TDT4295-2019-groupA/PCB/Synthesizer.kicad_pcb

## KiCad design Synthesizer.kicad_pcb (2019-10-03)

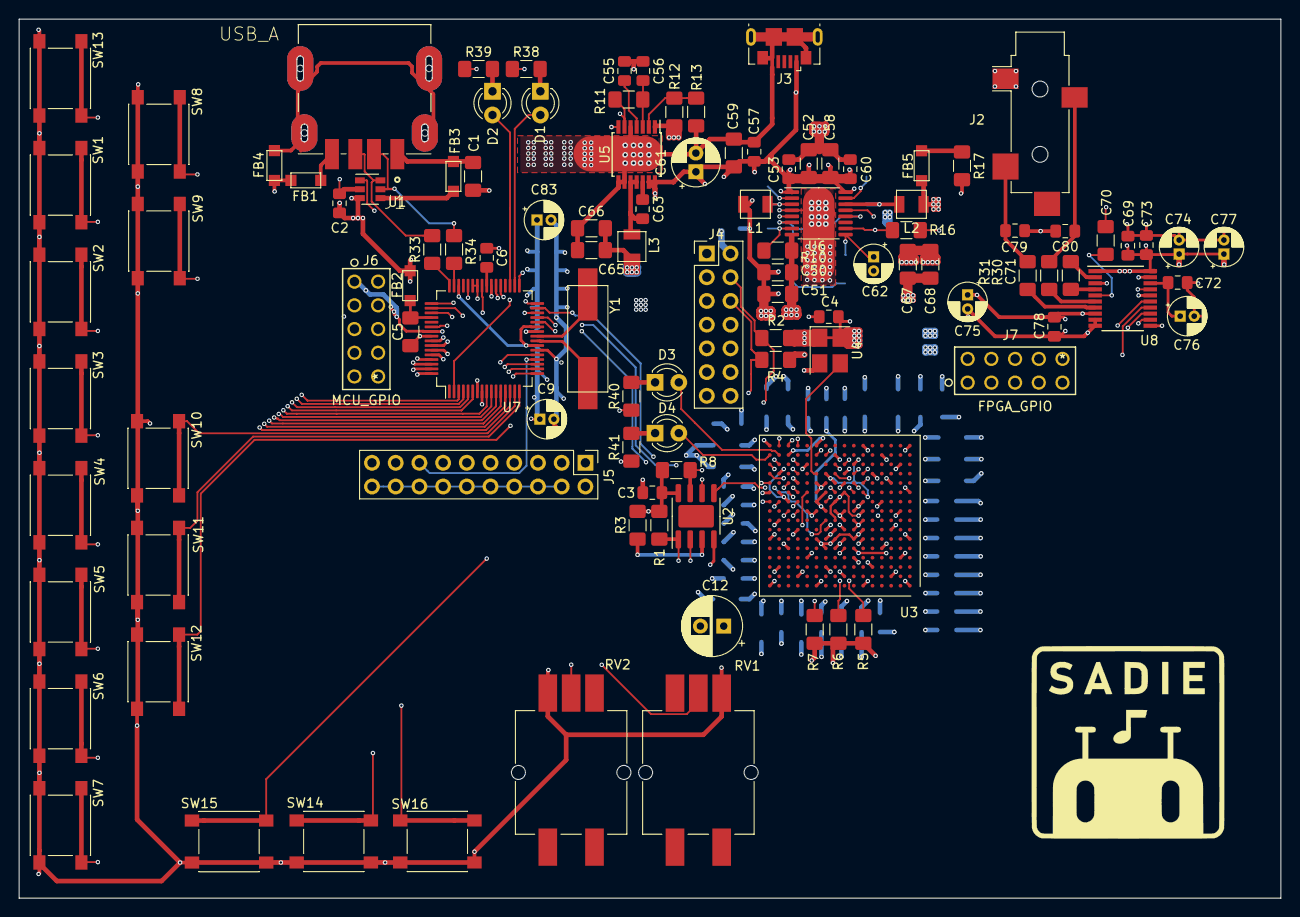
[picture p1: board Synthesizer.kicad_pcb from above]

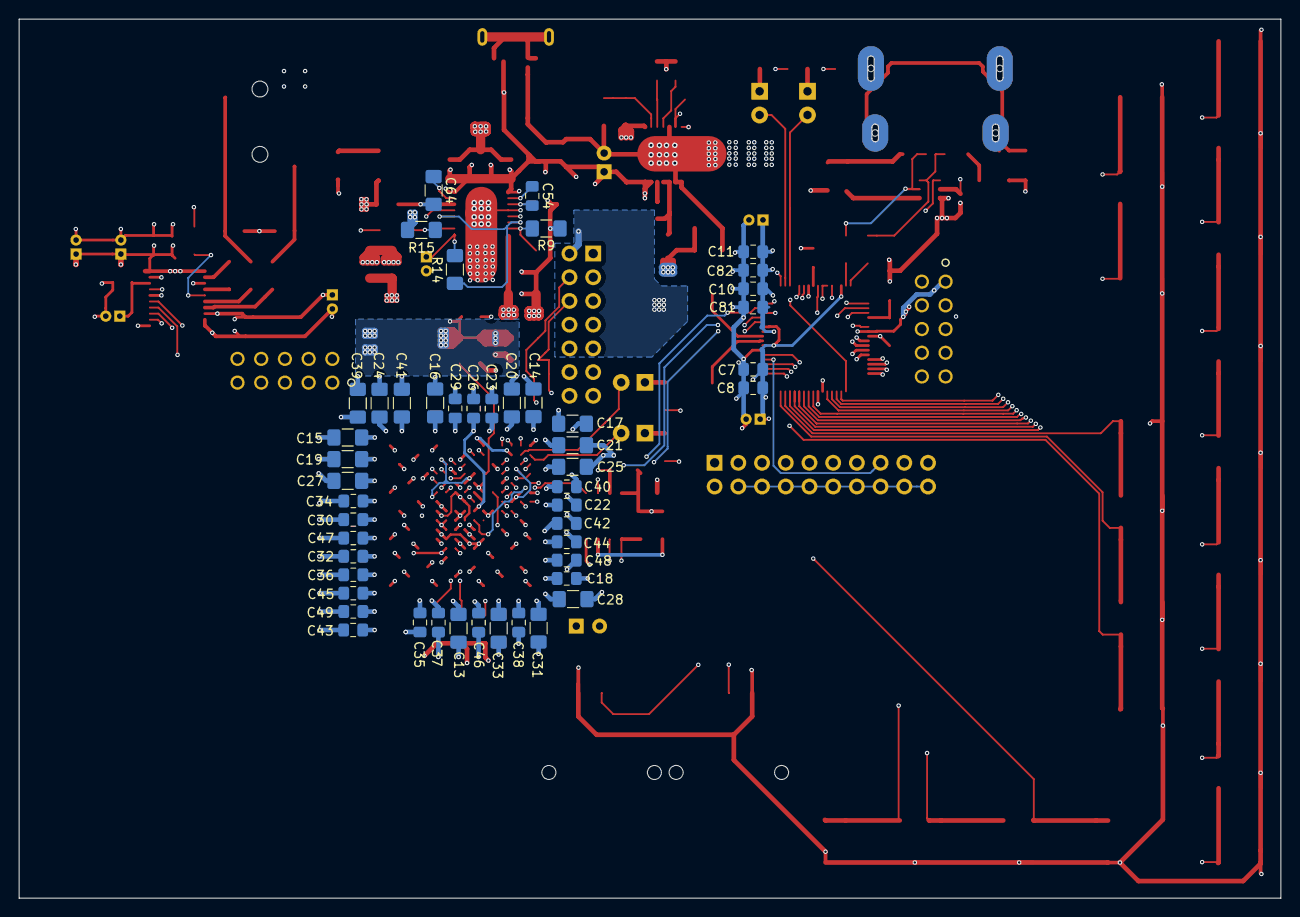
[picture p2: board Synthesizer.kicad_pcb from below]

Board: 6 copper layers, 135.2 x 94.2 mm, 154 parts (48 on the bottom side), 114 nets.

Parts:
C1: 150u; C_1206_3216Metric_Pad1.42x1.75mm_HandSolder
C2, C3, C4, C7, C8, C10, C11, C53, C54, C57, C60, C63, C69, C72, C73, C78, C81, C82: 100n; C_0805_2012Metric_Pad1.15x1.40mm_HandSolder
C5, C13, C19: 100u; C_1206_3216Metric_Pad1.42x1.75mm_HandSolder
C6, C56: 1u; C_0805_2012Metric_Pad1.15x1.40mm_HandSolder
C9, C74, C75, C76, C77, C83: 10u; CP_Radial_D4.0mm_P1.50mm
C12: 330u; CP_Radial_D6.3mm_P2.50mm
C14, C15: 47u; C_1206_3216Metric_Pad1.42x1.75mm_HandSolder
C16, C17, C20, C21, C24, C25, C27, C28, C31, C33, C39, C41: 4.7u; C_1206_3216Metric_Pad1.42x1.75mm_HandSolder
C18, C22, C23, C26, C29, C30, C32, C34, C35, C36, C37, C38, C40, C42, C43, C44, C45, C46, C47, C48, C49: 470n; C_0805_2012Metric_Pad1.15x1.40mm_HandSolder
C50, C51, C65, C66, C67, C68: 22u; C_1206_3216Metric_Pad1.42x1.75mm_HandSolder
C52, C58, C59: 10u; C_1206_3216Metric_Pad1.42x1.75mm_HandSolder
C55: 3.3n; C_0805_2012Metric_Pad1.15x1.40mm_HandSolder
C61: 100u; CP_Radial_D5.0mm_P2.00mm
C62: 1u; CP_Radial_D4.0mm_P1.50mm
C64: 100n; C_1206_3216Metric_Pad1.42x1.75mm_HandSolder
C70, C71: 2.2u; C_1206_3216Metric_Pad1.42x1.75mm_HandSolder
C79, C80: 2.2n; C_0805_2012Metric_Pad1.15x1.40mm_HandSolder
D1, D2, D3, D4: LED; LED_D3.0mm
FB1, FB2, FB3, FB4, FB5: Ferrite_Bead; FerriteBead_74279215
J1: USB_A; TE_1932638-3
J2: AudioJack3; Jack_3.5mm_CUI_SJ-3524-SMT_Horizontal
J3: USB_B_Micro; USB_Micro-B_GCT_USB3076-30-A
J4: FPGA_debug; PinHeader_2x07_P2.54mm_Vertical
J5: MCU_debug; PinHeader_2x10_P2.54mm_Vertical
J6: MCU_GPIO; 67997-410HLF
J7: FPGA_GPIO; 67997-410HLF
L1, L3: 1.5u; L_SPM3015
L2: 2.2u; L_SPM3015
R1: 2.4k; R_1206_3216Metric_Pad1.42x1.75mm_HandSolder
R2, R4: 10k; R_1206_3216Metric_Pad1.42x1.75mm_HandSolder
R3, R5, R6, R8: 4.7k; R_1206_3216Metric_Pad1.42x1.75mm_HandSolder
R7: 330; R_1206_3216Metric_Pad1.42x1.75mm_HandSolder
R9: 30.1k; R_1206_3216Metric_Pad1.42x1.75mm_HandSolder
R10, R13, R16: 22.1k; R_1206_3216Metric_Pad1.42x1.75mm_HandSolder
R11, R14: 100k; R_1206_3216Metric_Pad1.42x1.75mm_HandSolder
R12: 6.81k; R_1206_3216Metric_Pad1.42x1.75mm_HandSolder
R15: 73.2k; R_1206_3216Metric_Pad1.42x1.75mm_HandSolder
R17: 1; R_1206_3216Metric_Pad1.42x1.75mm_HandSolder
R30, R31: 470; R_1206_3216Metric_Pad1.42x1.75mm_HandSolder
R33, R34: 33; R_1206_3216Metric_Pad1.42x1.75mm_HandSolder
R38: 100; R_1206_3216Metric_Pad1.42x1.75mm_HandSolder
R39: 160; R_1206_3216Metric_Pad1.42x1.75mm_HandSolder
R40: 250; R_1206_3216Metric_Pad1.42x1.75mm_HandSolder
R41: 400; R_1206_3216Metric_Pad1.42x1.75mm_HandSolder
RV1, RV2: R_POT; Potentiometer_Bourns_PRS11S_Vertical
SW1, SW2, SW3, SW4, SW5, SW6, SW7, SW8, SW9, SW10, SW11, SW12, SW13, SW14, SW15, SW16: SW_Push; SW_Push_1P1T_NO_6x6mm_H9.5mm
U1: TPD3S014; SOT-23-6
U2: S25FL127S; SOIC-8-1EP_3.9x4.9mm_P1.27mm_EP2.41x3.81mm
U3: XC7A100T-FTG256; Xilinx_FTG256
U4: Oscillator; Oscillator_SMD_Abracon_ASE-4Pin_3.2x2.5mm_HandSoldering
U5: TPS54325; TSSOP-14-1EP_4.4x5mm_P0.65mm
U6: TPS54294; HTSSOP-16-1EP_4.4x5mm_P0.65mm_EP3x3mm
U7: EFM32GG11B4xx; TQFP-64_10x10mm_P0.5mm
U8: PCM5102; TSSOP-20_4.4x6.5mm_P0.65mm
Y1: 48Mhz; Crystal_SMD_Abracon_L11.4mm_W4.70mm_2pin

Connections:
+1V0: C12.1, C13.1, C17.1, C18.1, C21.1, C22.1, C25.1, C28.1, C31.1, C33.1, C35.1, C37.1, C38.1, C40.1, C42.1, C44.1, C46.1, C48.1, C65.1, C66.1, L3.2, R12.2, U3.E10, U3.F7, U3.F9, U3.F11, U3.G6, U3.H9, U3.J6, U3.K9, U3.L8, U5.1
+1V8: C14.1, C16.1, C20.1, C23.1, C26.1, C29.1, C50.1, C51.1, L1.1, R9.1, U3.G8, U3.G10, U3.J10, U3.K11, U3.L10
+3.3VA: C7.1, C8.1, C9.1, C75.1, C78.1, R17.1, U7.23, U7.27, U7.46, U8.8
+3V3: C3.1, C4.1, C10.1, C11.1, C15.1, C19.1, C24.1, C27.1, C30.1, C32.1, C34.1, C36.1, C39.1, C41.1, C43.1, C45.1, C47.1, C49.1, C67.1, C68.1, C69.1, C73.2, C74.1, C77.1, C81.1, C82.1, C83.1, FB5.1, J4.2, J5.1, J6.1, J7.1, L2.2, R1.1, R2.1, R3.1, R4.1, R5.1, R6.1, R7.1, R8.1, R15.1, RV1.1, RV2.3, SW1.1, SW2.1, SW3.1, SW4.1, SW5.1, SW6.1, SW7.1, SW8.1, SW9.1, SW10.1, SW11.1, SW12.1, SW13.1, SW14.1, SW15.1, SW16.1, U2.8, U3.E7, U3.L6, U3.L16, U3.M9, U3.M13, U3.N10, U3.P7, U3.R14, U3.T11, U4.1, U4.4, U7.7, U7.26, U7.39, U7.55, U8.1, U8.20
+5V: C2.2, C52.1, C53.1, C57.1, C58.1, C59.1, C60.1, C61.1, FB2.1, J3.1, U1.3, U5.7, U5.13, U5.14, U6.1, U6.16
/Artix7/DAC_LRCK: U3.L13, U8.15
/Artix7/DAC_SCK: U3.L14, U8.12
/Artix7/GREEN_LED: D4.2, U3.R16
/Artix7/RED_LED: D3.2, U3.R15
/Artix7/SPI_CLK: U3.P15, U7.30
/Artix7/SPI_CS: U3.P16, U7.31
/Artix7/SPI_MISO: U3.N16, U7.29
/Artix7/SPI_MOSI: U3.M16, U7.28
/Audio DAC/Audio-data: U3.K13, U8.14
/Audio DAC/Bit-clock: U3.M14, U8.13
/Audio DAC/OUTL: C80.1, J2.R, R30.1
/Audio DAC/OUTR: C79.1, J2.T, R31.1
/Audio DAC/Soft-mute: U7.2, U8.17
/Button0: SW13.2, U7.3
/Button1: SW1.2, U7.4
/Button2: SW2.2, U7.5
/Button3: SW3.2, U7.6
/Button4: SW4.2, U7.9
/Button5: SW5.2, U7.10
/Button6: SW6.2, U7.11
/Button7: SW7.2, U7.12
/Button8: SW8.2, U7.13
/Button9: SW9.2, U7.14
/Button10: SW10.2, U7.15
/Button11: SW11.2, U7.16
/Button12: SW12.2, U7.17
/Button13: SW15.2, U7.18
/Button14: SW14.2, U7.19
/Button15: SW16.2, U7.21
/EFM32/FPGA_Ready: R7.2, U3.H10, U7.38
/EFM32/FPGA_Reset: R6.2, U3.L9, U7.37
/EFM32/FPGA_extra_1: U3.T14, U7.41
/EFM32/FPGA_extra_2: U3.N13, U3.T15, U7.42, U7.43
/EFM32/FPGA_extra_4: U3.P13, U7.44
/EFM32/GREEN_LED: D2.2, U7.35
/EFM32/RED_LED: D1.2, U7.34
/EFM32/USB_D+: R33.1, U7.48
/EFM32/USB_D-: R34.1, U7.47
/EFM32/USB_VBUSEN: U1.1, U7.54
GND: C1.1, C2.1, C3.2, C4.2, C5.2, C6.1, C7.2, C8.2, C9.2, C10.2, C11.2, C12.2, C13.2, C14.2, C15.2, C16.2, C17.2, C18.2, C19.2, C20.2, C21.2, C22.2, C23.2, C24.2, C25.2, C26.2, C27.2, C28.2, C29.2, C30.2, C31.2, C32.2, C33.2, C34.2, C35.2, C36.2, C37.2, C38.2, C39.2, C40.2, C41.2, C42.2, C43.2, C44.2, C45.2, C46.2, C47.2, C48.2, C49.2, C50.2, C51.2, C52.2, C53.2, C55.2, C56.2, C57.2, C58.2, C59.2, C60.2, C61.2, C62.2, C65.2, C66.2, C67.2, C68.2, C69.2, C70.2, C72.1, C73.1, C74.2, C75.2, C76.2, C77.2, C78.2, C79.2, C80.2, C81.2, C82.2, C83.2, FB1.2, FB4.2, J2.S, J3.5, J3.6, J4.1, J4.3, J4.5, J4.7, J4.9, J4.11, J4.13, J5.4, J5.6, J5.8, J5.10, J5.12, J5.14, J5.16, J5.18, J5.20, J6.10, J7.10, R10.2, R13.1, R16.2, R38.1, R39.1, R40.1, R41.1, U1.2, U2.4, U3.A1, U3.A6, U3.A11, U3.A16, U3.B3, U3.B8, U3.B13, U3.C5, U3.C10, U3.C15, U3.D2, U3.D7, U3.D12, U3.E4, U3.E9, U3.E14, U3.F1, U3.F6, U3.F8, U3.F10, U3.F16, U3.G3, U3.G7, U3.G9, U3.G13, U3.H6, U3.H7, U3.H8, U3.H15, U3.J2, U3.J7, U3.J8, U3.J9, U3.J11, U3.J12, U3.K4, U3.K6, U3.K14, U3.L1, U3.L11, U3.L15, U3.M3, U3.M8, U3.M10, U3.M11, U3.N5, U3.N15, U3.P2, U3.P12, U3.R4, U3.R9, U3.T1, U3.T6, U3.T16, U4.2, U5.5, U5.8, U5.9, U5.15, U6.4, U6.8, U6.13, U6.17, U7.8, U7.22, U7.56, U8.3, U8.9, U8.10, U8.11, U8.16, U8.19
unnamed: C1.2, FB3.2, J1.1
unnamed: C5.1, FB2.2, U7.52
unnamed: C6.2, U7.40
unnamed: C54.1, U6.2
unnamed: C54.2, L1.2, U6.3
unnamed: C55.1, U5.4
unnamed: C56.1, R11.1, U5.3
unnamed: C62.1, R14.1, U6.9
unnamed: C63.1, L3.1, U5.10, U5.11
unnamed: C63.2, U5.12
unnamed: C64.1, U6.15
unnamed: C64.2, L2.1, U6.14
unnamed: C70.1, U8.5
unnamed: C71.1, U8.2
unnamed: C71.2, U8.4
unnamed: C72.2, C76.1, U8.18
unnamed: D1.1, R38.2
unnamed: D2.1, R39.2
unnamed: D3.1, R40.2
unnamed: D4.1, R41.2
unnamed: FB1.1, J1.4
unnamed: FB3.1, U1.4
unnamed: FB4.1, J1.5
unnamed: FB5.2, R17.2
unnamed: J1.2, R34.2, U1.5
unnamed: J1.3, R33.2, U1.6
unnamed: J4.4, R2.2, U3.M7
unnamed: J4.6, R4.2, U3.L7
unnamed: J4.8, U3.N8
unnamed: J4.10, U3.N7
unnamed: J5.7, U7.50
unnamed: J5.9, U7.49
unnamed: J5.13, U7.51
unnamed: J5.15, U7.20
unnamed: J6.2, U7.58
unnamed: J6.3, U7.60
unnamed: J6.4, U7.62
unnamed: J6.5, U7.64
unnamed: J6.6, U7.57
unnamed: J6.7, U7.59
unnamed: J6.8, U7.61
unnamed: J6.9, U7.63
unnamed: J7.2, U3.P8
unnamed: J7.3, U3.N6
unnamed: J7.4, U3.M6
unnamed: J7.5, U3.P9
unnamed: J7.6, U3.T13
unnamed: J7.7, U3.R10
unnamed: J7.8, U3.R11
unnamed: J7.9, U3.N9
unnamed: R1.2, U2.1, U3.L12
unnamed: R3.2, U2.3, U3.K15
unnamed: R5.2, U3.K10
unnamed: R8.2, U2.7, U3.K16
unnamed: R9.2, R10.1, U6.7
unnamed: R11.2, U5.6, U6.5
unnamed: R12.1, R13.2, U5.2
unnamed: R14.2, U6.6, U6.12
unnamed: R15.2, R16.1, U6.10
unnamed: R30.2, U8.6
unnamed: R31.2, U8.7
unnamed: RV1.2, U7.32
unnamed: RV2.2, U7.33
unnamed: U2.2, U3.J14
unnamed: U2.5, U3.J13
unnamed: U2.6, U3.E8
unnamed: U3.N11, U4.3
unnamed: U7.24, Y1.1
unnamed: U7.25, Y1.2
