TDT4295-2019-groupA/PCB/(commit log)

2019-09-12 Added EFM32GG11 symbol
    [FPGA_DecCaps.sch, Synthesizer.sch]
2019-09-12 Split EFM32GG symbol, creating one unit (D) exclusively for power connectors The rest are placeholders until we know how it makes sense to split them up. The lecture slides had 4 units, so i set it t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
    [Synthesizer.sch]
2019-09-12 La til hele Artix7-kretsen
    [Artix.sch, FPGADecCaps.sch, FPGA_DecCaps.sch, Synthesizer.sch]
2019-09-12 Extra decouplers in FPGA-sheet
    [Artix.sch, FPGADecCaps.sch, Synthesizer.sch]
2019-09-12 add decouplers for MCU and connect them to unit D
    [FPGA_DecCaps.sch, Synthesizer.sch]
2019-09-13 Add capacitors to FPGA Decouplers to match datasheet for XC7A100T Split up the Vcco capacitors again into the banks as described in the datasheet. Copy a row of banks if we end up needing more io pin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
    [FPGADecCaps.sch, FPGA_DecCaps.sch]
2019-09-13 Added TPS54294 schematic to the library.
2019-09-13 Added TPS54325 schematic to the library.
2019-09-13 Added PSU... I think...
    [PSU.sch, Synthesizer.sch]
2019-09-15 Mye har skjedd
    [Artix.sch, FPGADecCaps.sch, PSU.sch, PowerSupply.sch, Synthesizer.kicad_pcb, Synthesizer.sch]
2019-09-16 use +3.3V symbol instead of wires with labels in Artix.sch
    [Artix.sch]
2019-09-17 Label POWER -> Power Symbol
    [Artix.sch]
2019-09-17 use power symbols for 1V0 1V8
    [Artix.sch, FPGADecCaps.sch]
2019-09-17 Starten på et PCB layout
    [Synthesizer.kicad_pcb]
2019-09-17 split EFM32GG into units for AB, C, D, EF
    [Synthesizer.sch]
2019-09-17 Fixed FPGA decouplers so they deliver power. Removed Synthesizer-cache lib.
    [Artix.sch, FPGADecCaps.sch, PSU.sch, Synthesizer.sch]
2019-09-17 Removed empty PowerSupply schematic.
    [PowerSupply.sch]
2019-09-17 Added DAC subsheet.
    [Artix.sch, AudioDac.sch, FPGADecCaps.sch, PSU.sch, Synthesizer.sch]
2019-09-18 Updated DAC pin names, wired some to ground.
    [AudioDac.sch, Synthesizer.sch]
2019-09-18 Oopsy-woopsy fucky-wucky
    [Artix.sch, AudioDac.sch, FPGADecCaps.sch, PSU.sch, Synthesizer.sch]
2019-09-19 Better footprints
    [Artix.sch, AudioDac.sch, FPGADecCaps.sch, PSU.sch, Synthesizer.sch]
2019-09-19 Wired DAC to FPGA.
    [Artix.sch, Synthesizer.sch]
2019-09-19 La oss ta det litt piano, folkens
    [Synthesizer.kicad_pcb, Synthesizer.sch]
2019-09-19 Added audio jack and footprint
    [Synthesizer.kicad_pcb, Synthesizer.sch]
2019-09-19 Change the project to use the new MCU
    [Artix.sch, AudioDac.sch, EFM32.sch, FPGADecCaps.sch, MCUDecouplers.sch, PSU.sch, Synthesizer.sch]
2019-09-20 Connect the MCU SPI pins to FPGA
    [EFM32.sch, Synthesizer.sch]
2019-09-20 Connect FPGA done and program_b pin to some pins on the MCU
    [Artix.sch, AudioDac.sch, EFM32.sch, FPGADecCaps.sch, MCUDecouplers.sch, PSU.sch, Synthesizer.sch]
2019-09-20 Add USB symbol and pins
    [EFM32.sch, Synthesizer.sch]
2019-09-23 Wired up minijack and micro-USB.
    [Synthesizer.sch]
2019-09-23 Wired USB-A. Added a capacitor to USB_VBUS in the schematic. No idea what to do about VBUSEN though.
    [EFM32.sch, Synthesizer.sch]
2019-09-23 Added ESD protection to USB-A. Connected Soft-mute.
    [EFM32.sch, Synthesizer.sch]
2019-09-23 Added power source for USB-A.
    [EFM32.sch, Synthesizer.sch]
2019-09-23 Added forgotten USB-B power source, powered bank 14 of FPGA.
    [Artix.sch, Synthesizer.sch]
2019-09-23 Re-add SPI connections inside Artix sheet Thank mr. kicad for fantastic VCS support
    [Artix.sch]
2019-09-24 add placeholder footprints, clean up ratsnest a bit
    [Artix.sch, EFM32.sch, MCUDecouplers.sch, Synthesizer.kicad_pcb, Synthesizer.sch]
2019-09-24 Connect buttons and move MCU->FPGA done/program_b pins
    [EFM32.sch, MCUDecouplers.sch, Synthesizer.sch]
2019-09-25 Added NPN transistor on USB and wired shield. Added LEDs, debug pins.
    [Artix.sch, EFM32.sch, Synthesizer.sch]
2019-09-25 Fixed buttons, FPGA wires that were accidentally connected to GND.
    [EFM32.sch]
2019-09-25 Add header for MCU GPIO
    [EFM32.sch, MCUDecouplers.sch, Synthesizer.kicad_pcb, Synthesizer.sch]
2019-09-25 Give footprints to LEDs
    [Synthesizer.kicad_pcb, Synthesizer.sch]
2019-09-25 Slight prettification
    [Artix.sch]
2019-09-25 Update PCB design rules
    [Synthesizer.kicad_pcb]
2019-09-26 Fix USB connections and various cleanup
    [AudioDac.sch, EFM32.sch, PSU.sch, Synthesizer.kicad_pcb, Synthesizer.sch]
2019-09-26 Rearrange PCB components to more closely match schematics and take up less space
    [Artix.sch, AudioDac.sch, Synthesizer.kicad_pcb, Synthesizer.sch]
2019-09-26 Added resistors on LEDs.
    [Synthesizer.sch]
2019-09-26 Fixed LED bugs again. I think it's right now.
    [EFM32.sch, Synthesizer.sch]
2019-09-26 Last fix to LEDs... Oops
    [Synthesizer.sch]
2019-09-26 Fixed u being written as µ (my bad.) Tried doing work on the PSU but it's eldritch.
    [PSU.sch, Synthesizer.kicad_pcb]
2019-09-26 Added crystal footprint. Also, moved REF on LED so it would be legible.
2019-09-26 Added bill of materials. Also, fixed one of the USB capacitors...
    [Synthesizer.sch]
2019-09-26 Route tracks for buttons among other things
    [Synthesizer.kicad_pcb]
2019-09-27 Fixed crystal footprint to comply with recommended land pattern. Fixed merge.
    [Synthesizer.sch]
2019-09-27 Added Ferride Bead footprint
2019-09-27 Updated component footprints. The PCB is now an unholy mess.
    [Artix.sch, AudioDac.sch, EFM32.sch, FPGADecCaps.sch, MCUDecouplers.sch, PSU.sch, Synthesizer.kicad_pcb, Synthesizer.sch]
2019-09-27 Tag you're it. Wired up the DAC, fixed the PSU footprint.
    [Artix.sch, PSU.sch, Synthesizer.kicad_pcb, Synthesizer.sch]
2019-09-27 Added potentiometers to EFM32. Haven't updated the physical layout for it.
    [EFM32.sch]
2019-09-27 I forgot to annotate things again
    [Artix.sch, EFM32.sch]
2019-09-27 Added in the potentiometers, fixed some faulty pins on the artix, rewired some pins on the MCU so they didn't interfere with the crystal.
    [Artix.sch, EFM32.sch, Synthesizer.kicad_pcb, Synthesizer.sch]
2019-09-27 Wired up the potentiometers.
    [Artix.sch, AudioDac.sch, EFM32.sch, Synthesizer.kicad_pcb, Synthesizer.sch]
2019-09-27 Started wiring the flash chip.
    [Artix.sch, EFM32.sch, Synthesizer.kicad_pcb]
2019-09-27 Fix via diameters to fit FPGA and fix some via connections
    [Synthesizer.kicad_pcb]
2019-09-27 Add vias to most FPGA pins and reroute many long surface traces through them
    [Synthesizer.kicad_pcb]
2019-09-27 Added 3.3V and GND power planes and started placing vias for them
    [Synthesizer.kicad_pcb]
2019-09-28 Revert "Added 3.3V and GND power planes and started placing vias for them"
    A lot of this has to be redone, and it'll be faster to revert everything than to undo most of it. Sorry.
    This reverts commit 094bcba739ea07dc7ad5aae56f3abc91d941740f.
    [Synthesizer.kicad_pcb]
2019-09-28 Added footprint for the coils we're using.
2019-09-28 Fixed coil footprint oops
2019-09-28 Wire up 1V PSU. Use smaller footprints for small caps.
    [Artix.sch, AudioDac.sch, EFM32.sch, FPGADecCaps.sch, MCUDecouplers.sch, PSU.sch, Synthesizer.kicad_pcb, Synthesizer.sch]
2019-09-28 Added USB-A receptacle footprint.
2019-09-28 Wire up other PSU
    [Synthesizer.kicad_pcb]
2019-09-28 Rearrange and rewire most of the PCB
    [Artix.sch, Synthesizer.kicad_pcb]
2019-09-29 Added in a bunch of footprints to the netlist; only missing buttons and some resistors, now.
    [Artix.sch, AudioDac.sch, FPGADecCaps.sch, MCUDecouplers.sch, PSU.sch, Synthesizer.sch]
2019-09-29 add missing button traces, tidy up labels a bit
    [Synthesizer.kicad_pcb]
2019-09-29 add logo draft(?)
    [Synthesizer.kicad_pcb]
2019-09-29 Revert "add logo draft(?)"
    This reverts commit 0874d0c373619f7d5d47854bd0a0fb4f43bdef77.
    [Synthesizer.kicad_pcb]
2019-09-29 Revert "add missing button traces, tidy up labels a bit"
    This reverts commit 2afccf877748aad07f819f0c8185ed7717c89559.
    [Synthesizer.kicad_pcb]
2019-09-29 Revert "Added in a bunch of footprints to the netlist; only missing buttons and some resistors, now."
    This reverts commit 26f31b12234d03a706d1f0abb84aa744ef749ada.
    [Artix.sch, AudioDac.sch, FPGADecCaps.sch, MCUDecouplers.sch, PSU.sch, Synthesizer.sch]
2019-09-29 Rearrange and wire most of PCB FOR REAL THIS TIME
    [EFM32.sch, Synthesizer.kicad_pcb]
2019-09-29 "Merge" footprint changes and netlist
    [AudioDac.sch, FPGADecCaps.sch, MCUDecouplers.sch, PSU.sch, Synthesizer.sch]
2019-09-29 Readd logo
    [Synthesizer.kicad_pcb]
2019-09-29 Connect 3V pin of MCU GPIO
    [Synthesizer.kicad_pcb]
2019-09-29 Move one capacitor so it doesn't clip with a resistor
    [Synthesizer.kicad_pcb]
2019-09-29 Fix a few more noclipping objects and labels
    [Artix.sch, EFM32.sch, Synthesizer.kicad_pcb]
2019-09-29 Fix floating "USB A" label
    [Synthesizer.kicad_pcb]
2019-09-29 Fix more noclipping components
    [Synthesizer.kicad_pcb]
2019-09-29 Forgot to save for the previous one
    [Synthesizer.kicad_pcb]
2019-09-30 Removed pull-down resistors.
    [EFM32.sch, PSU.sch, Synthesizer.kicad_pcb, Synthesizer.sch]
2019-09-30 wire up buttons
    [Synthesizer.kicad_pcb]
2019-09-30 update logo
    [Synthesizer.kicad_pcb]
2019-09-30 Fixed pin header footprints, rewired. I think it's done?
    [Artix.sch, Synthesizer.kicad_pcb]
2019-09-30 Fixed DRC errors. It's done
    [Synthesizer.kicad_pcb]
2019-09-30 Pushed up Micro-USB so it's on PCB edge.
    [Synthesizer.kicad_pcb]
2019-09-30 add back logo
    [Synthesizer.kicad_pcb]
2019-09-30 add labels for debug headers, fix some other labels
    [Synthesizer.kicad_pcb]
2019-09-30 Fix one erroneous trace. VERY REVOLUTIONARY CHANGES
    [Synthesizer.kicad_pcb]
2019-10-02 Changed a capacitor value from 100u to 150u. (oopsiedaisy)
    [Synthesizer.kicad_pcb, Synthesizer.sch]
2019-10-02 Replaced oscillator with a larger footprint and rewired. Also changed track width on some USB-A wires.
    [Synthesizer.kicad_pcb]
2019-10-02 Move FPGA decoupling caps. Rewire some PWR/GND pins
    [Synthesizer.kicad_pcb]
2019-10-03 add power planes, spam vias everywhere
    [Synthesizer.kicad_pcb]
2019-10-03 Thicken some power traces under the FPGA
    [Synthesizer.kicad_pcb]
2019-10-03 Thicken traces and thin planes
    [Synthesizer.kicad_pcb]
2019-10-03 Thicken 1.8V layer
    [Synthesizer.kicad_pcb]
